bryceehill/MarshmallowBot/BotTailWheel.stl

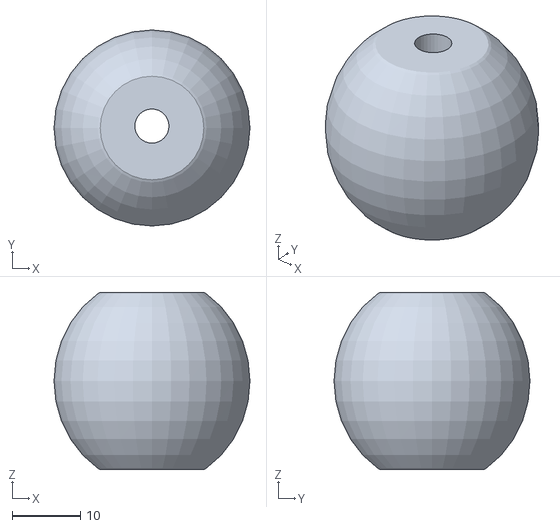
[picture p1: CAD file, 2026-09-30]
BotTailWheel.stl
28.8 x 28.8 x 26.0
