bryceehill/MarshmallowBot/BotChassis.stl

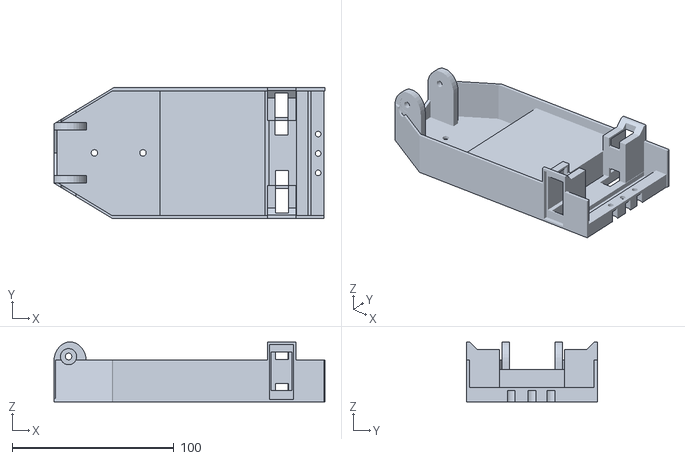
[picture p2: CAD file, 2026-09-30]
BotChassis.stl
167.5 x 81.1 x 37.0
