bryceehill/MarshmallowBot/MouseTrapLauncher.stl

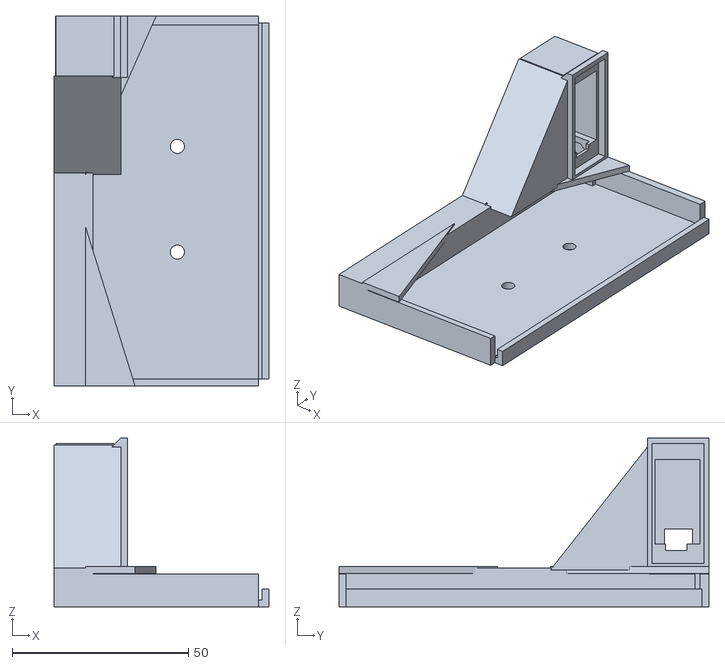
[picture p3: CAD file, 2026-09-30]
MouseTrapLauncher.stl
61.0 x 105.0 x 47.9
