bryceehill/MarshmallowBot/(commit log)

2026-09-30 Arduino File for the ESP32 C3 microcontroller
    First upload of the ESP32 code
2026-09-30 Bot Assembly Instructions
2026-09-30 Update README with components and 3D print parts
    Added a list of components and parts to 3D print for the Marshmallow Bot.
2026-09-30 Update README with assembly instructions
    Added instructions for mounting hardware and soldering steps.
2026-09-30 Revise README with updated instructions and parts list
    Updated parts list and added detailed instructions for soldering, connecting components, programming, and optional marshmallow launcher setup.
2026-09-30 Enhance README with marshmallow launcher setup details
    Added instructions for setting up the marshmallow launcher and connecting to the ESP32 C3.
2026-09-30 STL Files for printing
    [BotChassis.stl, BotTailWheel.stl, MouseTrapLauncher.stl]
